PiyuSX/PiPad/README.md

# PiPad

### A custom 3×3 mechanical macropad built from scratch.

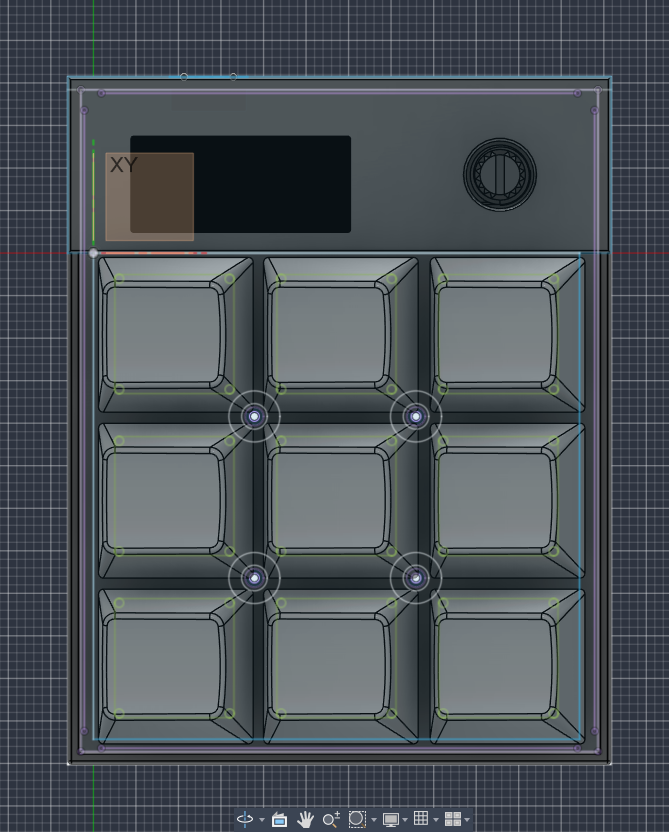
[picture p1: images/Screenshot 2026-11-10 123623.png]
PiPad PCB render


## About

PiPad is a 3x3 macropad that I designed and build myself.It features 9 mechnical keys, a rotary encoder and an OLED display(128x32).

I started this project to get into Electronics and to learn PCB design , 3D CAD modelling and embedded firmware dev.

## Features

- 9 mechnical keys
- Rotary encoder
- OLED display 128x32
- 4 profiles
- 36 macros
- Custom QMK firmware

## Design

### PCB Design

Designed using KiCad

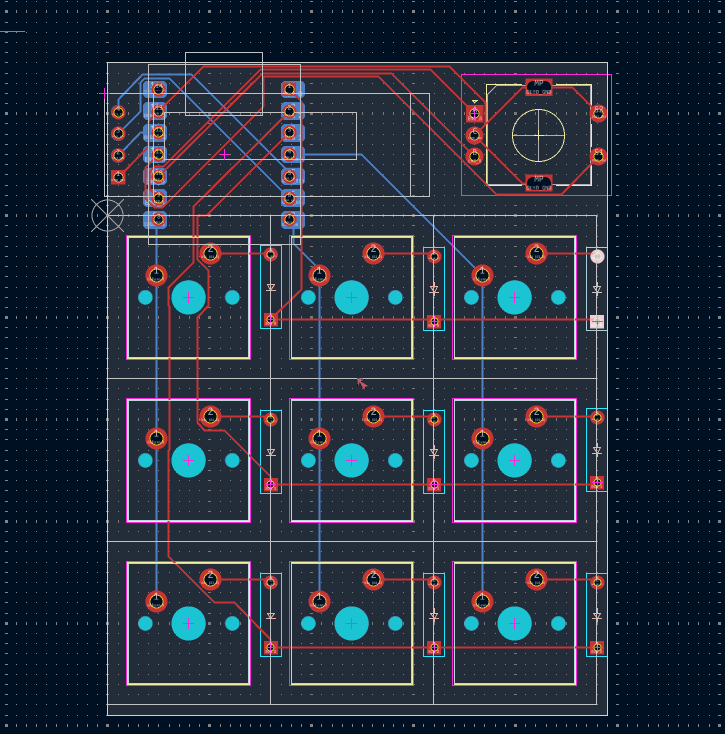
[picture p2: images/Screenshot 2026-11-08 145440.png]
PiPad PCB Render


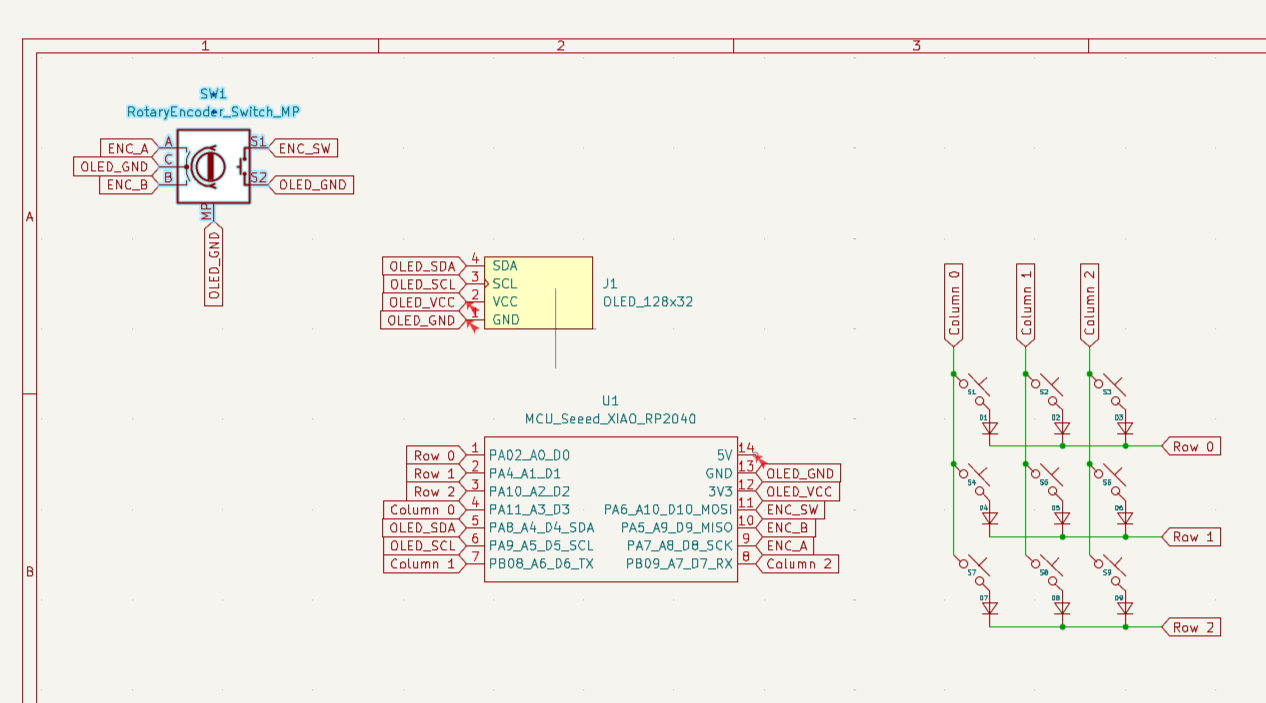
[picture p3: images/Screenshot 2026-11-07 211734.png]
PiPad Enclosure CAD


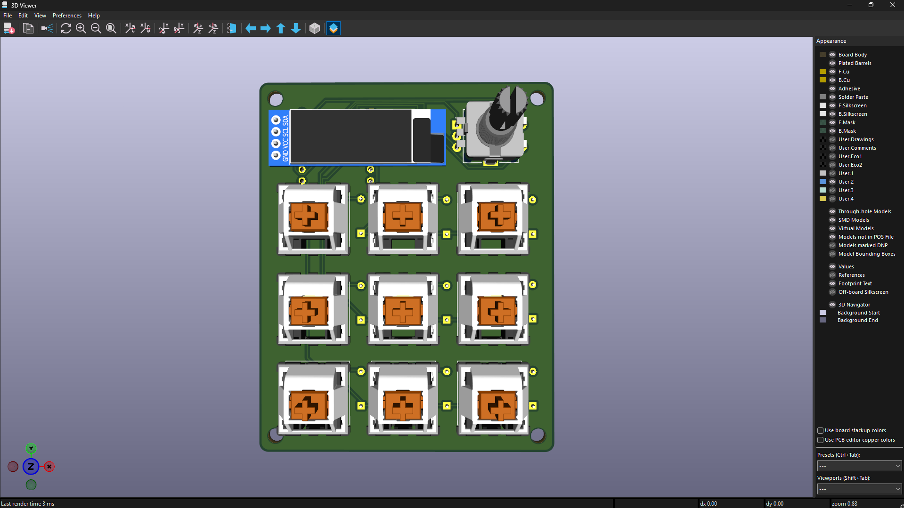
[picture p4: images/front.png]
PiPad Final Render


### 3D Enclosure

The enclosure was made in Fusin 360. I went through multiple versions to reduce the overall size and achieved a cleaner and minimal design.
It includes mounting points, a type C opening 

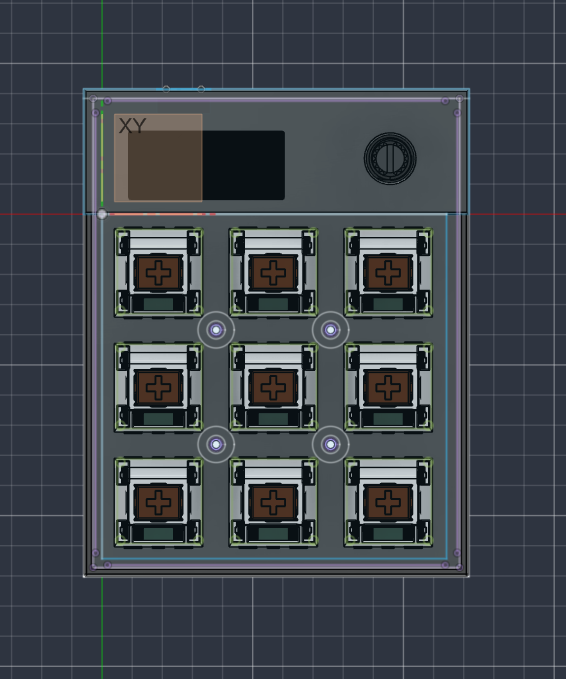
[picture p5: images/Screenshot 2026-11-10 123814.png]


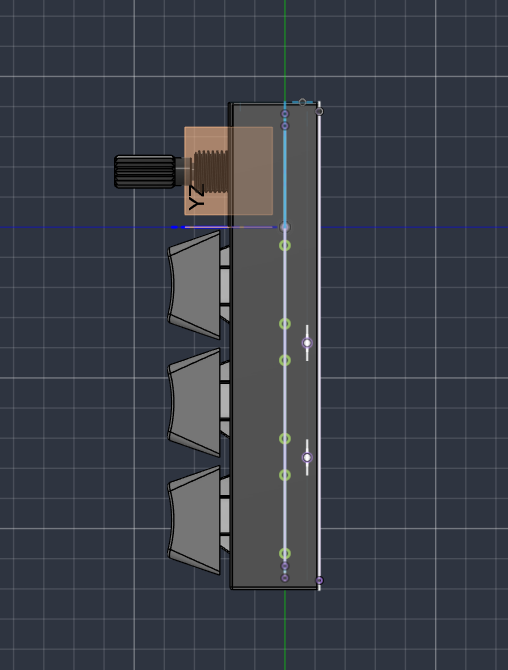
[picture p6: images/Screenshot 2026-11-10 123706.png]


## Firmware

PiPad uses [QMK Firmware](https://github.com/qmk/qmk_firmware).

The firmware is configured with four profiles, each containing nine key positions, giving a total of 36 configurable macro positions.

The default key layout uses the F13–F21 key range.

```text
┌─────┬─────┬─────┐
│ F13 │ F14 │ F15 │
├─────┼─────┼─────┤
│ F16 │ F17 │ F18 │
├─────┼─────┼─────┤
│ F19 │ F20 │ F21 │
└─────┴─────┴─────┘
```

The firmware currently compiles successfully. Physical hardware testing is still pending.

## Development Journal

I documented the dev process, including the mistakes, redesigns and time spent on each process

**[Read the Development Journal →](JOURNAL.md)**

## Credits & Resources

- [QMK Firmware](https://github.com/qmk/qmk_firmware) – Keyboard firmware framework.
- [Joe Scotto's ScottoKicad](https://github.com/joe-scotto/scottokeebs/tree/main/Extras/ScottoKicad) – KiCad assets and resources used during PCB design.

## Bill of Materials

| Product | Qty | Price (USD) |
|---|---|---|
| Epomaker silent linear switches | 9 | $4.11 |
| Seeed XIAO RP2040 | 1 | $3.90 |
| 1N4148 diodes | 9 | $0.27 |
| Rotary encoder with push button | 1 | $1.30 |
| OLED 128x32 I2C display | 1 | $2.80 |
| Custom PCB (JLCPCB) | 1 | $4.00 |
| 3D printed case (JLC3DP), body + plate | 1 set | $4.00 |
| Blank black keycaps (MX) | 9 | $4.95 |
| M2 x 4 x 3.2 heat-set inserts | 4 | $0.13 |
| M2 x 5 screws | 4 | $0.24 |
| Aluminum encoder knob | 1 | $4.50 |
| **Total** | | **$30.20** |

Note: This price was last updated at 2026 NOV 

## Author

**Piyush Rajbanshi**

- Email: [hi@piyushrajbanshi.com.np](mailto:hi@piyushrajbanshi.com.np)

## License

This project is licensed under the [MIT License](LICENSE).
