PiyuSX/PiPad/images/back.png

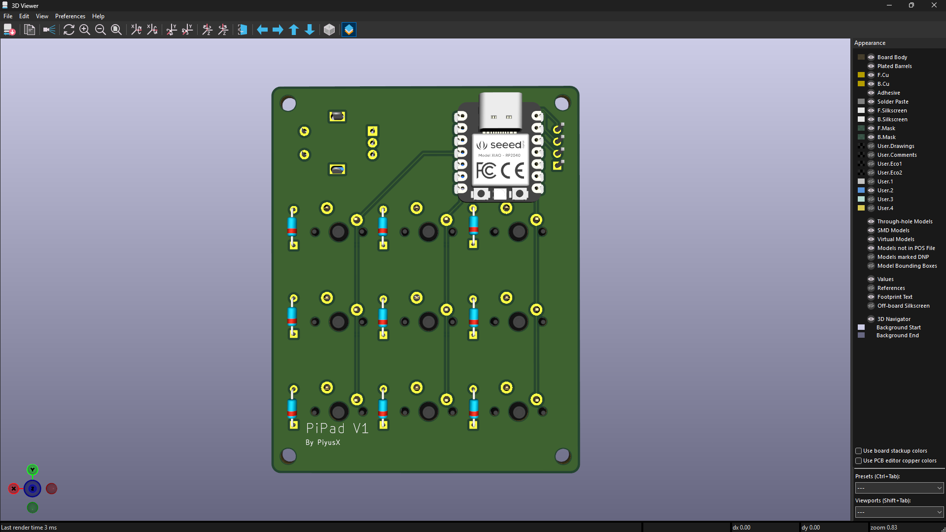
images/back.png
