PiyuSX/PiPad/BOM.csv

Part | Link | Qty needed | MOQ | Price paid (USD) | Cost of parts used (USD) | Notes
Epomaker silent linear switches | https://www.amazon.com/dp/B0BQJ9RGM2 | 9 | 35 | 16 | 4.11 | Cost used = 16.00 x 9 / pack size
Seeed XIAO RP2040 | https://www.seeedstudio.com/XIAO-RP2040-v1-0-p-5026.html | 1 | 1 | 3.9 | 3.9 | Microcontroller
1N4148 diodes | https://www.lcsc.com/product-detail/C258182.html | 9 | 20 | 0.59 | 0.27
Rotary encoder with push button | https://www.amazon.com/dp/B0C6Q67V97 | 1 | 6 | 8 | 1.3
OLED 128x32 I2C display | https://www.amazon.com/dp/B0F5PNMHRK | 1 | 5 | 14 | 2.8
Custom PCB (JLCPCB) | https://jlcpcb.com | 1 | TBD (min order) | 4 | 4 | Web price 4.00; app price 2.00 - confirm which one is used
3D printed case (JLC3DP) | https://jlc3dp.com/3d-printing-quote | 1 set | 1 set | 4 | 4 | Body + plate
Blank black keycaps (MX) | https://www.amazon.com/dp/B0CQ2XG16M | 9 | 20 | 11 | 4.95
M2 x 4 x 3.2 heat-set inserts | https://www.amazon.com/dp/B0DQL44Z2V | 4 | 150 | 5 | 0.13
M2 x 5 screws | https://www.amazon.com/dp/B0DLWPW8SN | 4 | 100 | 6 | 0.24
Aluminum encoder knob | https://www.amazon.com/dp/B07FVLVB55 | 1 | 2 | 9 | 4.5
TOTAL (known items only) |  |  |  | 81.49 | 24.79
