PiyuSX/PiPad/CAD/PiPad_Full_Assembly.step

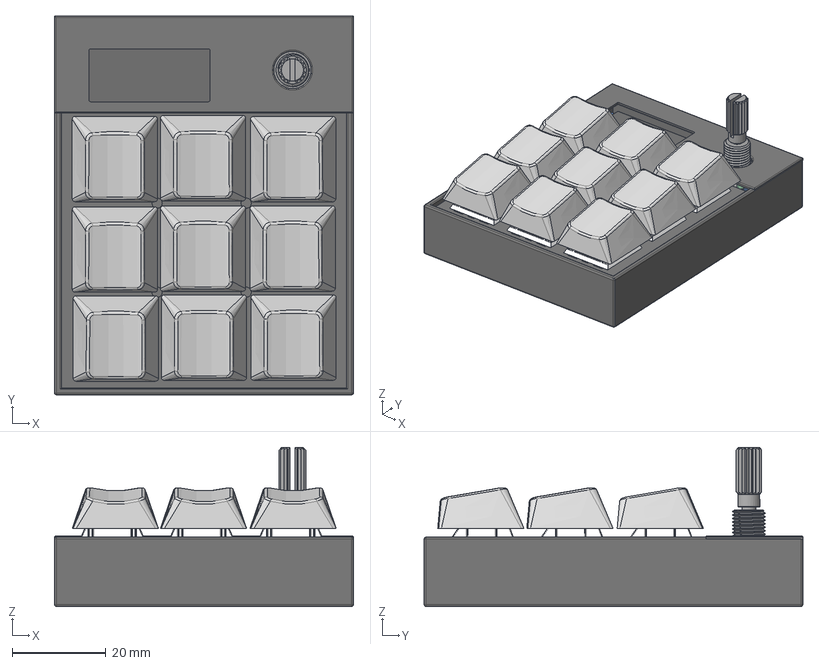
[picture p8: CAD file, 2026-11-10]
CAD/PiPad_Full_Assembly.step
63.8 x 80.8 x 33.9 mm
