PiyuSX/PiPad/CAD/TopPlate.stl

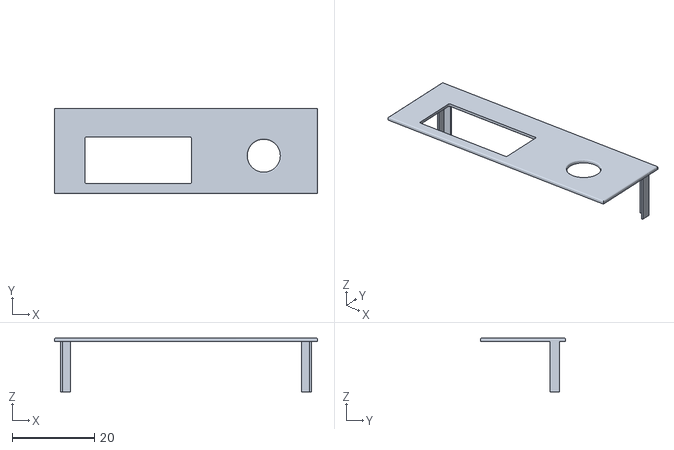
[picture p9: CAD file, 2026-11-11]
CAD/TopPlate.stl
63.8 x 20.7 x 13.1
