PiyuSX/PiPad/PCB/PiPad.step

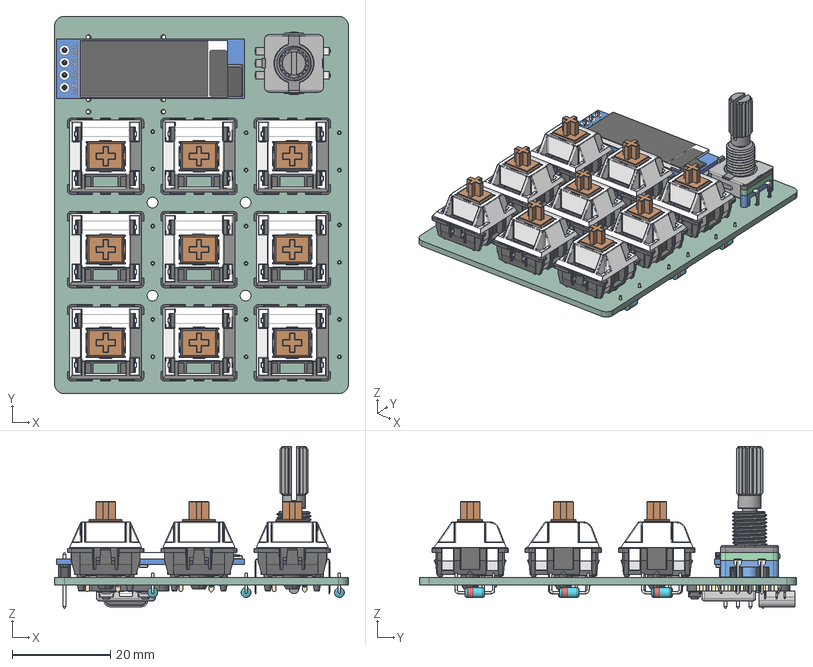
[picture p10: CAD file, 2026-11-10]
PCB/PiPad.step
60.0 x 77.0 x 33.1 mm
SW_Cherry_MX_PCB_cp x 9
EC11_Rotary_Encoder_Switched
OLED_0.91_128x32
Pin Header 4 x 1 TH 2.54mm Pitch
RESC-0603 x 13
2SD0601A
D_DO-35_SOD27_P7.62mm_Horizontal x 9
type-c v2
smd_button v3
DOUT
DIN
VSS
VDD
smd_button v3(Mirror)
MacroPad_PCB
