PiyuSX/PiPad/CAD/body.stl

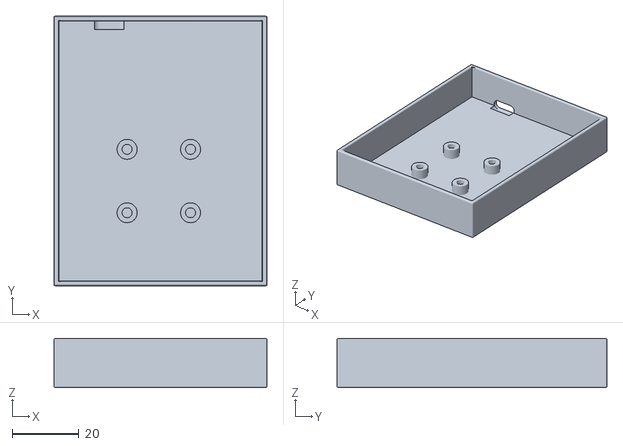
[picture p11: CAD file, 2026-11-11]
CAD/body.stl
63.8 x 80.8 x 14.8
