PiyuSX/PiPad/CAD/plate.stl

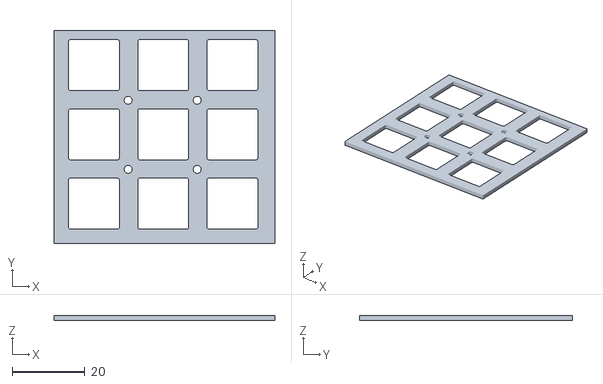
[picture p12: CAD file, 2026-11-10]
CAD/plate.stl
60.8 x 58.6 x 1.50
