PiyuSX/PiPad/(list of files, cad)

Other CAD files:
CAD/PIPad Fusion.f3z
