PiyuSX/PiPad/PCB/PiPad.kicad_pcb

## KiCad design PCB/PiPad.kicad_pcb (2026-11-10)

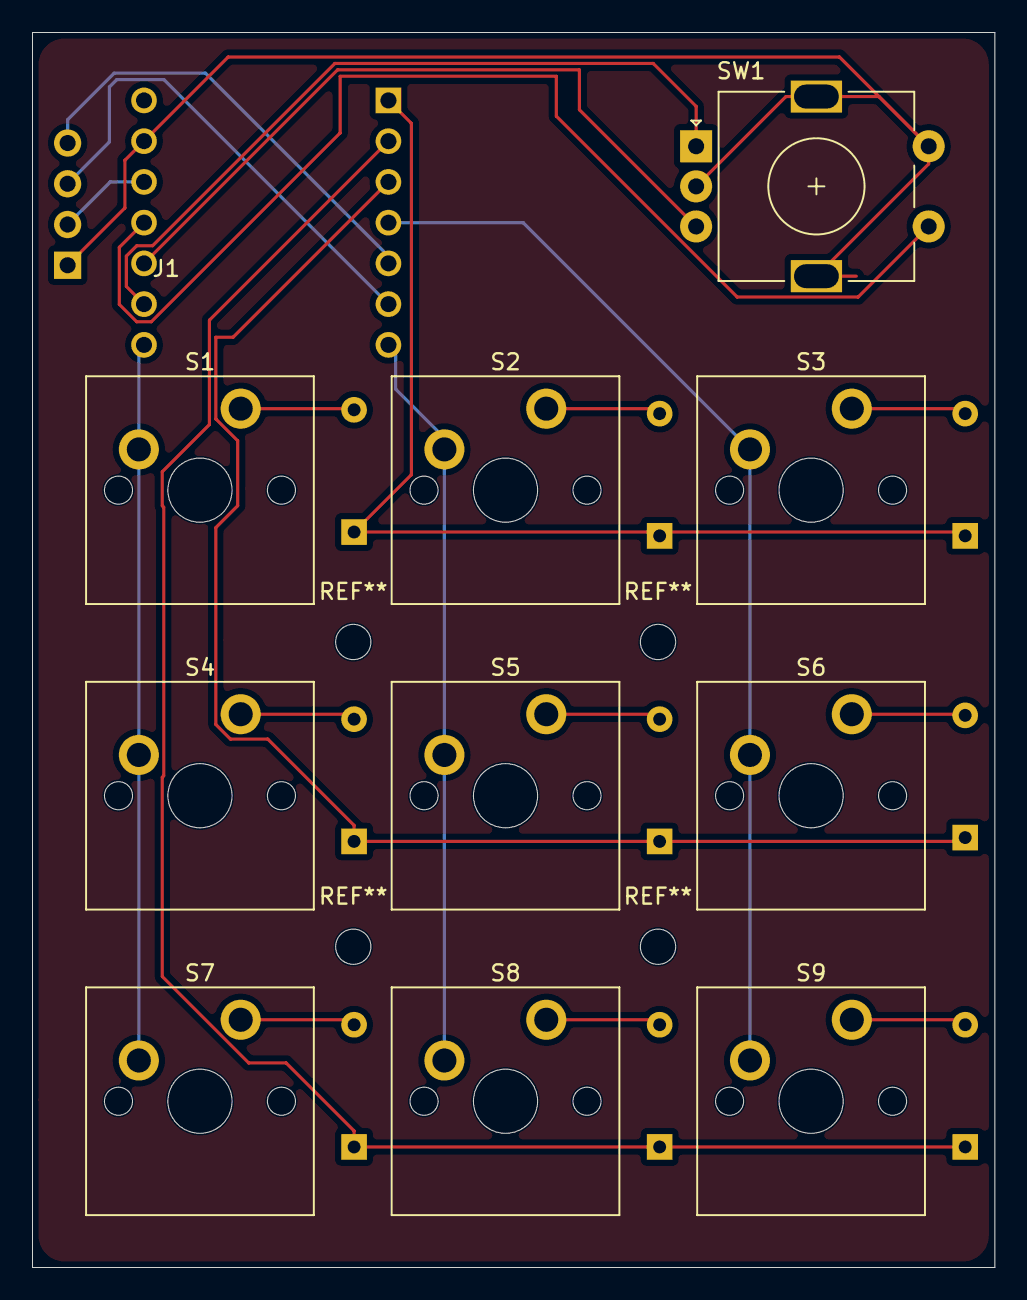
[picture p13: board PiPad.kicad_pcb from above]

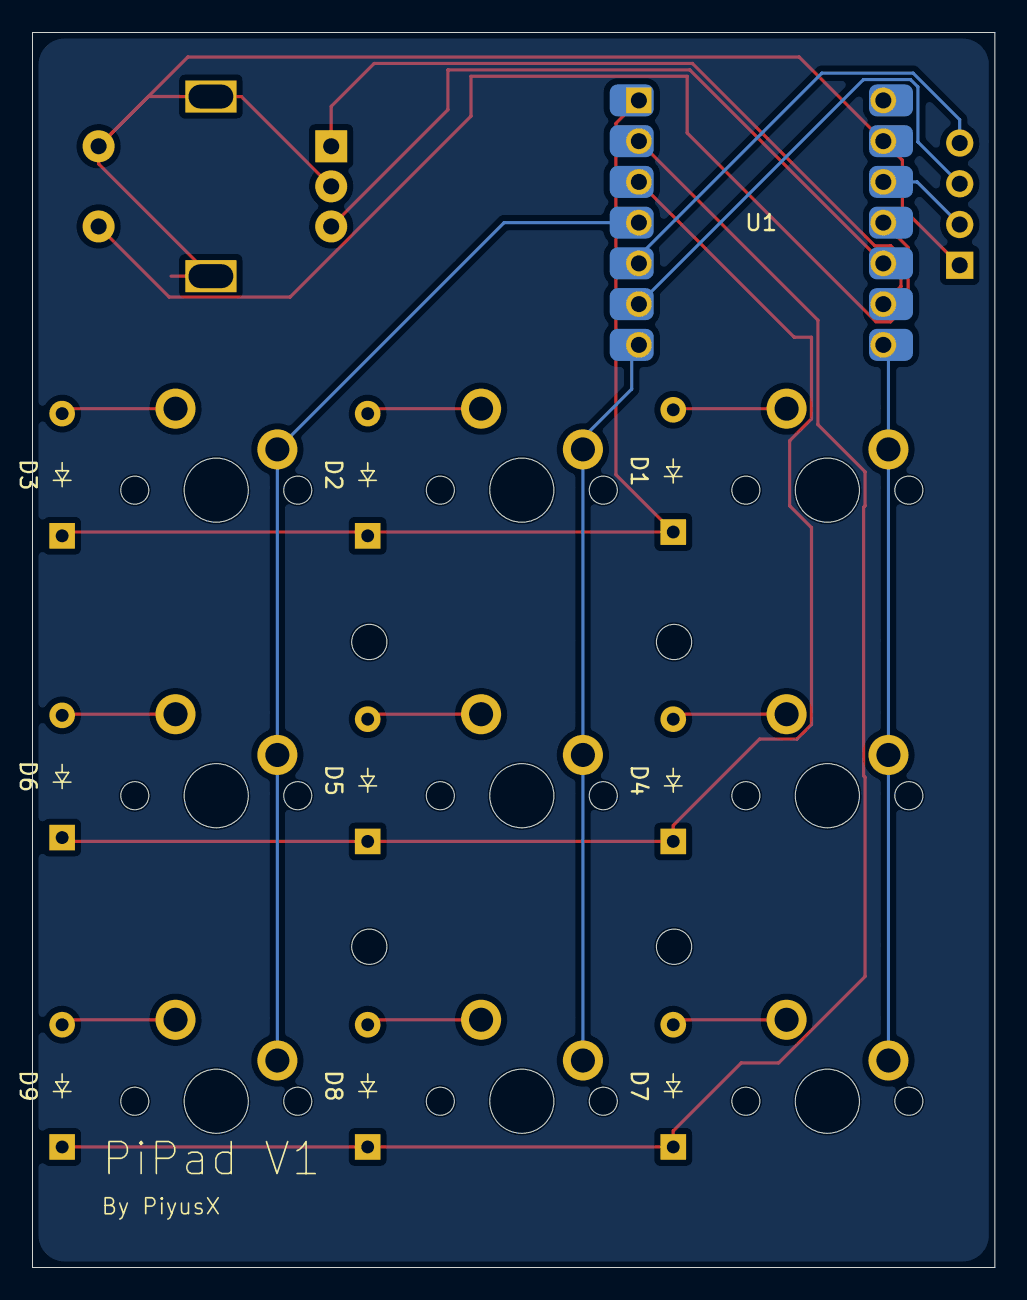
[picture p14: board PiPad.kicad_pcb from below]

Board: 2 copper layers, 60.0 x 77.0 mm, 21 parts (10 on the bottom side), 22 nets.

Parts:
D1, D2, D3, D4, D5, D6, D7, D8, D9: Diode_DO-35
J1: OLED_128x32
S1, S2, S3, S4, S5, S6, S7, S8, S9: MX_PCB_1.00u
SW1: RotaryEncoder_Switch_MP; RotaryEncoder_Alps_EC11E-Switch_Vertical_H20mm
U1: MCU_Seeed_XIAO_RP2040; Seeed_XIAO_RP2040

Connections:
Column 0: S1.1, S4.1, S7.1, U1.8 (PB09_A7_D7_RX)
Column 1: S2.1, S5.1, S8.1, U1.7 (PB08_A6_D6_TX)
Column 2: S3.1, S6.1, S9.1, U1.4 (PA11_A3_D3)
ENC_A: SW1.A, U1.9 (PA7_A8_D8_SCK)
ENC_B: SW1.B, U1.10 (PA5_A9_D9_MISO)
ENC_SW: SW1.S1, U1.11 (PA6_A10_D10_MOSI)
unnamed: D1.2 (A), S1.2
unnamed: D2.2 (A), S2.2
unnamed: D3.2 (A), S3.2
unnamed: D4.2 (A), S4.2
unnamed: D5.2 (A), S5.2
unnamed: D6.2 (A), S6.2
unnamed: D7.2 (A), S7.2
unnamed: D8.2 (A), S8.2
unnamed: D9.2 (A), S9.2
OLED_GND: J1.1 (GND), SW1.C, SW1.MP, SW1.S2, U1.13 (GND)
OLED_SCL: J1.3 (SCL), U1.6 (PA9_A5_D5_SCL)
OLED_SDA: J1.4 (SDA), U1.5 (PA8_A4_D4_SDA)
OLED_VCC: J1.2 (VCC), U1.12 (3V3)
Row 0: D1.1 (K), D2.1 (K), D3.1 (K), U1.1 (PA02_A0_D0)
Row 1: D4.1 (K), D5.1 (K), D6.1 (K), U1.3 (PA10_A2_D2)
Row 2: D7.1 (K), D8.1 (K), D9.1 (K), U1.2 (PA4_A1_D1)
