PiyuSX/PiPad/JOURNAL.md

---
title: "PiPad"
description: "A custom macro pad"
created_at: "2026-11-07"
total_time: "19h 36m" (Estimated Maybe More)
---

# November 7, 2026: Made the Schematics

Ahh i was watching Joe Scotto tutorial for KI CAD "How to Design Mechanical Keyboard PCBs with Kicad
" cuz i was totally begginer and still struggling from 2-3 hours for basics but Still havent figured out what the error was but i fixed it eventually. 

SO i have Made the schematics and in the PCB way and going on







**Total time spent: 3h 30m**

# November 7, 2026: More on PCB

I made this upto here so The thing is i forgot to add the battery and the knob so next i will be doing is updating the schematics and then im coming back soon



**Total time spent: 1h 48m**

# November 7, 2026: PCB design

I forgotted to add knob so i did it and there was some error in the 3d files so i downloaded it from external site and I attached the knob so this will be gonna the final Layout for this PiPad

Since im lil bit new so im taking much more time than a begginer and i followed upon tutorial for starting and now i can do things on my own and I added this Display , knob on my own the tutorial didnt had this and im loving this thanks hackclub for showing me my this side





**Total time spent: 1h**

# November 8, 2026: Routed the PCB 

Hmm today I fixed some errors , I today did the Wires routing part and I moved the board in left to that dont interfare with the Pins of the knob and the PCB parts are finally done and i Have produced the gerbers.zip using Fabricate plugin and Moving next to CAD.




**Total time spent: 3h**

# November 9, 2026: PCB CASE 



After making the 3d CAD design i got to know that my PIPad  got bulky SO i am rediting my PCB again to putting the screws to center and I want minimal design and after this i will design the CAD again in FUSION. Lol i might have OCD 

This much hours cuz im begginer and have to consume lots of tutorial for The 3d case



**Total time spent: 4h**

# November 9, 2026: CAD CASE 


As of OCD i redesined the whole case and still have some errors but fixing it tommorrow and with the the case is also 70% completed and Probably next i will be writing the Firmware

**Total time spent: 3h**

# November 10, 2026: More on Case 

SO today i completed the total Case , i smoothed the Edges and Made hole for display and Added screw poles and The Case is all done next I will be going to Make The Firmware




**Total time spent: 1h 30m**

# November 10, 2026: Firmware

I wrote the Firmware with QMK and its passing here but havent tested yet in the hardware cuz im broke to afford and I made it like 4 profiles with 9 keys so total 36 macros and its going from 

       ┌───-┬───-┬──-─┐
     * │ F13│ F14│ F15│
     * ├───-┼───-┼──-─┤
     * │ F16│ F17│ F18│
     * ├───-┼───-┼──-─┤
     * │ F19│ F20│ F21│
     * └───-┴───-┴───-┘

so Thats it 



**Total time spent: 1h 48m**
