PiyuSX/PiPad/(commit log)

2026-11-08 PCB files
    [MacroPad.kicad_pcb, MacroPad.kicad_sch]
2026-11-09 Update to the Alignment of the Knob
    [MacroPad.kicad_pcb]
2026-11-10 Add case STLs and Fusion archive
    [PIPad_Fusion.f3z, PiPad.kicad_pcb, PiPad.kicad_sch, PiPad.step, body.stl, plate.stl]
2026-11-10 Add BOM.csv file with component details and pricing
    [BOM.csv]
2026-11-10 Add PiPad full assembly STL file
    [PiPad_Full_Assembly.stl]
2026-11-10 Replace PiPad_Full_Assembly.stl with PiPad_Full_Assembly.step file
    [PiPad_Full_Assembly.step, PiPad_Full_Assembly.stl]
2026-11-11 Add new CAD files: PIPad Fusion.f3z, TopPlate.stl, and update body.stl
    [PIPad Fusion.f3z, PIPad_Fusion.f3z, TopPlate.stl, body.stl]
2026-11-12 Add Bill of Materials to README
    Added a Bill of Materials section with product details and pricing.
